tomaskovacik/ComfortTurnSignal/HW_kovo/pinout.jpg

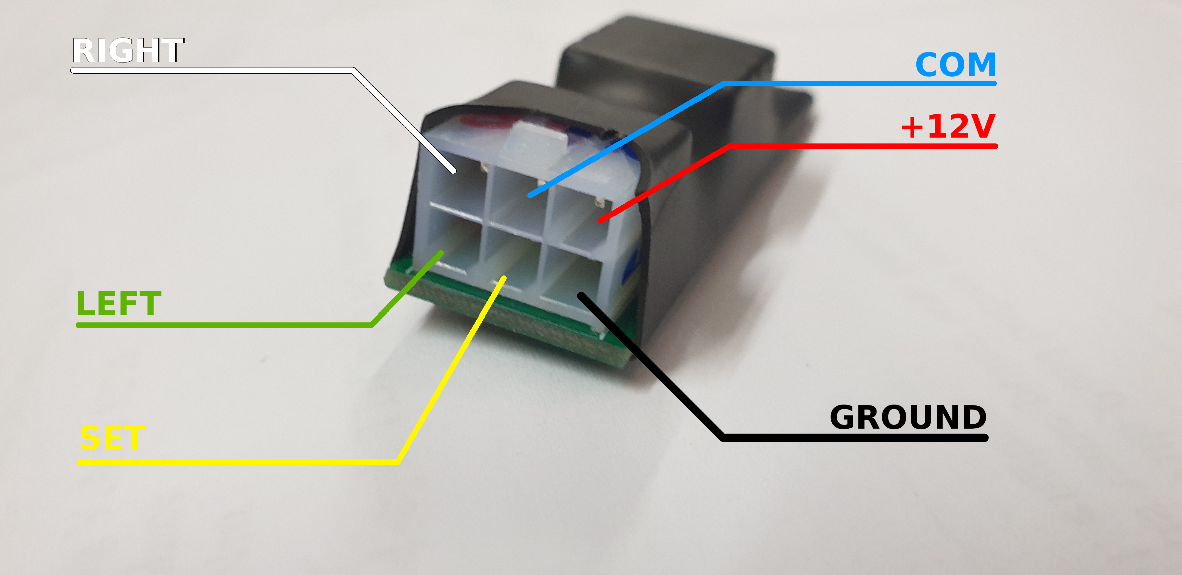
HW_kovo/pinout.jpg
