tomaskovacik/ComfortTurnSignal/HW_kovo/schematics_kovo.pdf

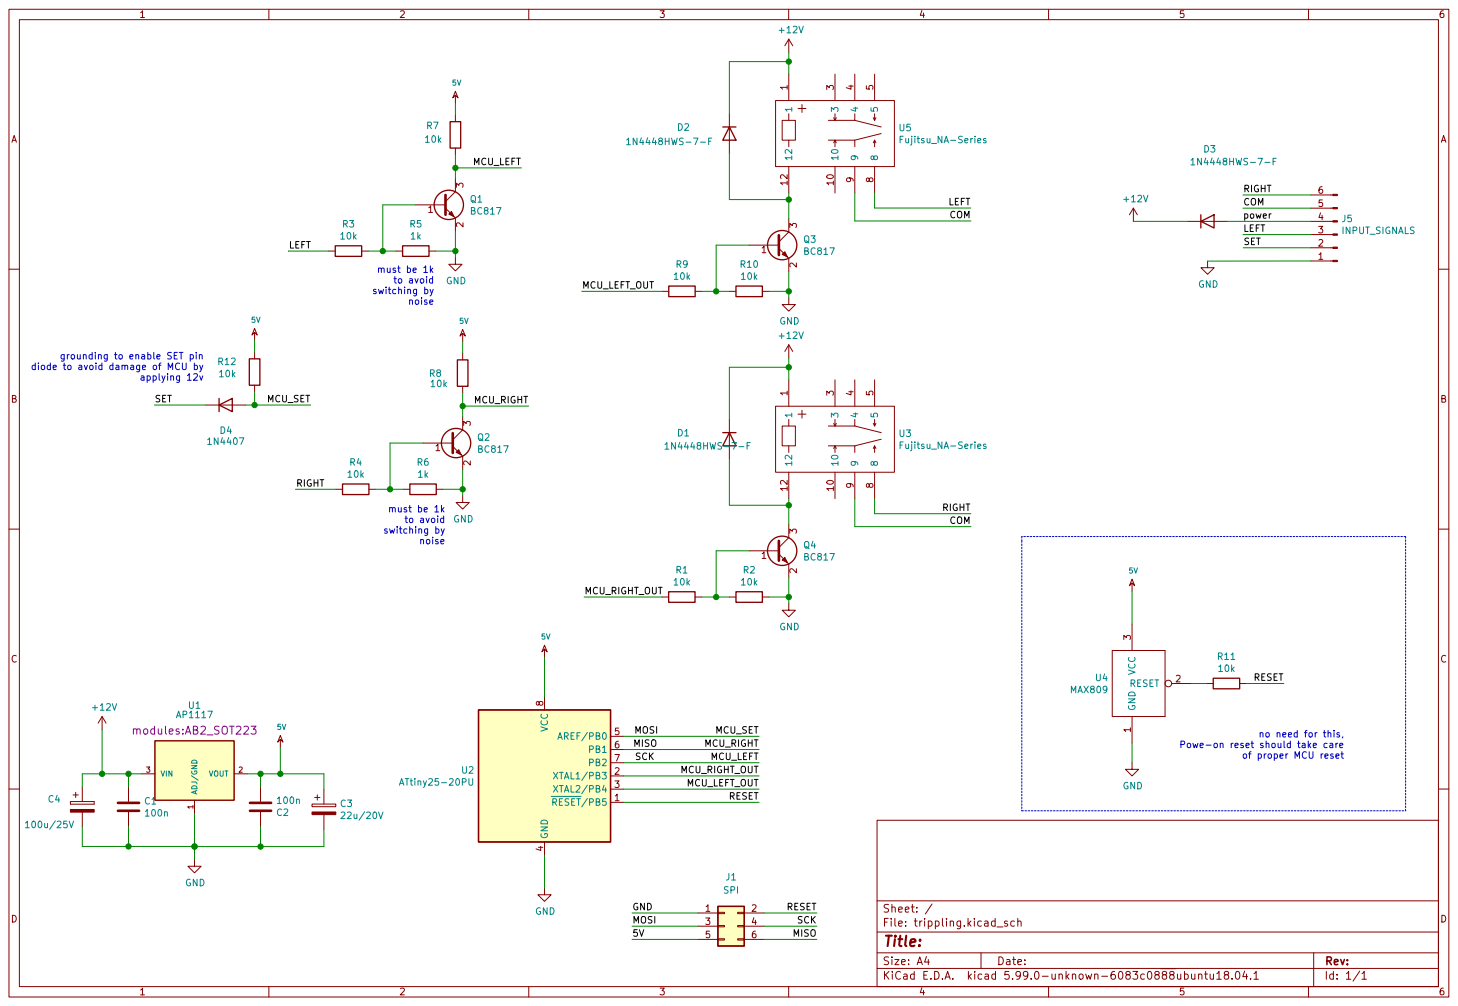
[picture p2: page 1]

switching by noise must be 1k

grounding to enable SET pin
diode to avoid damage of MCU by

of proper MCU reset
