tomaskovacik/ComfortTurnSignal/HW_kovo/trippling.kicad_pcb

## KiCad design HW_kovo/trippling.kicad_pcb (2021-08-12)

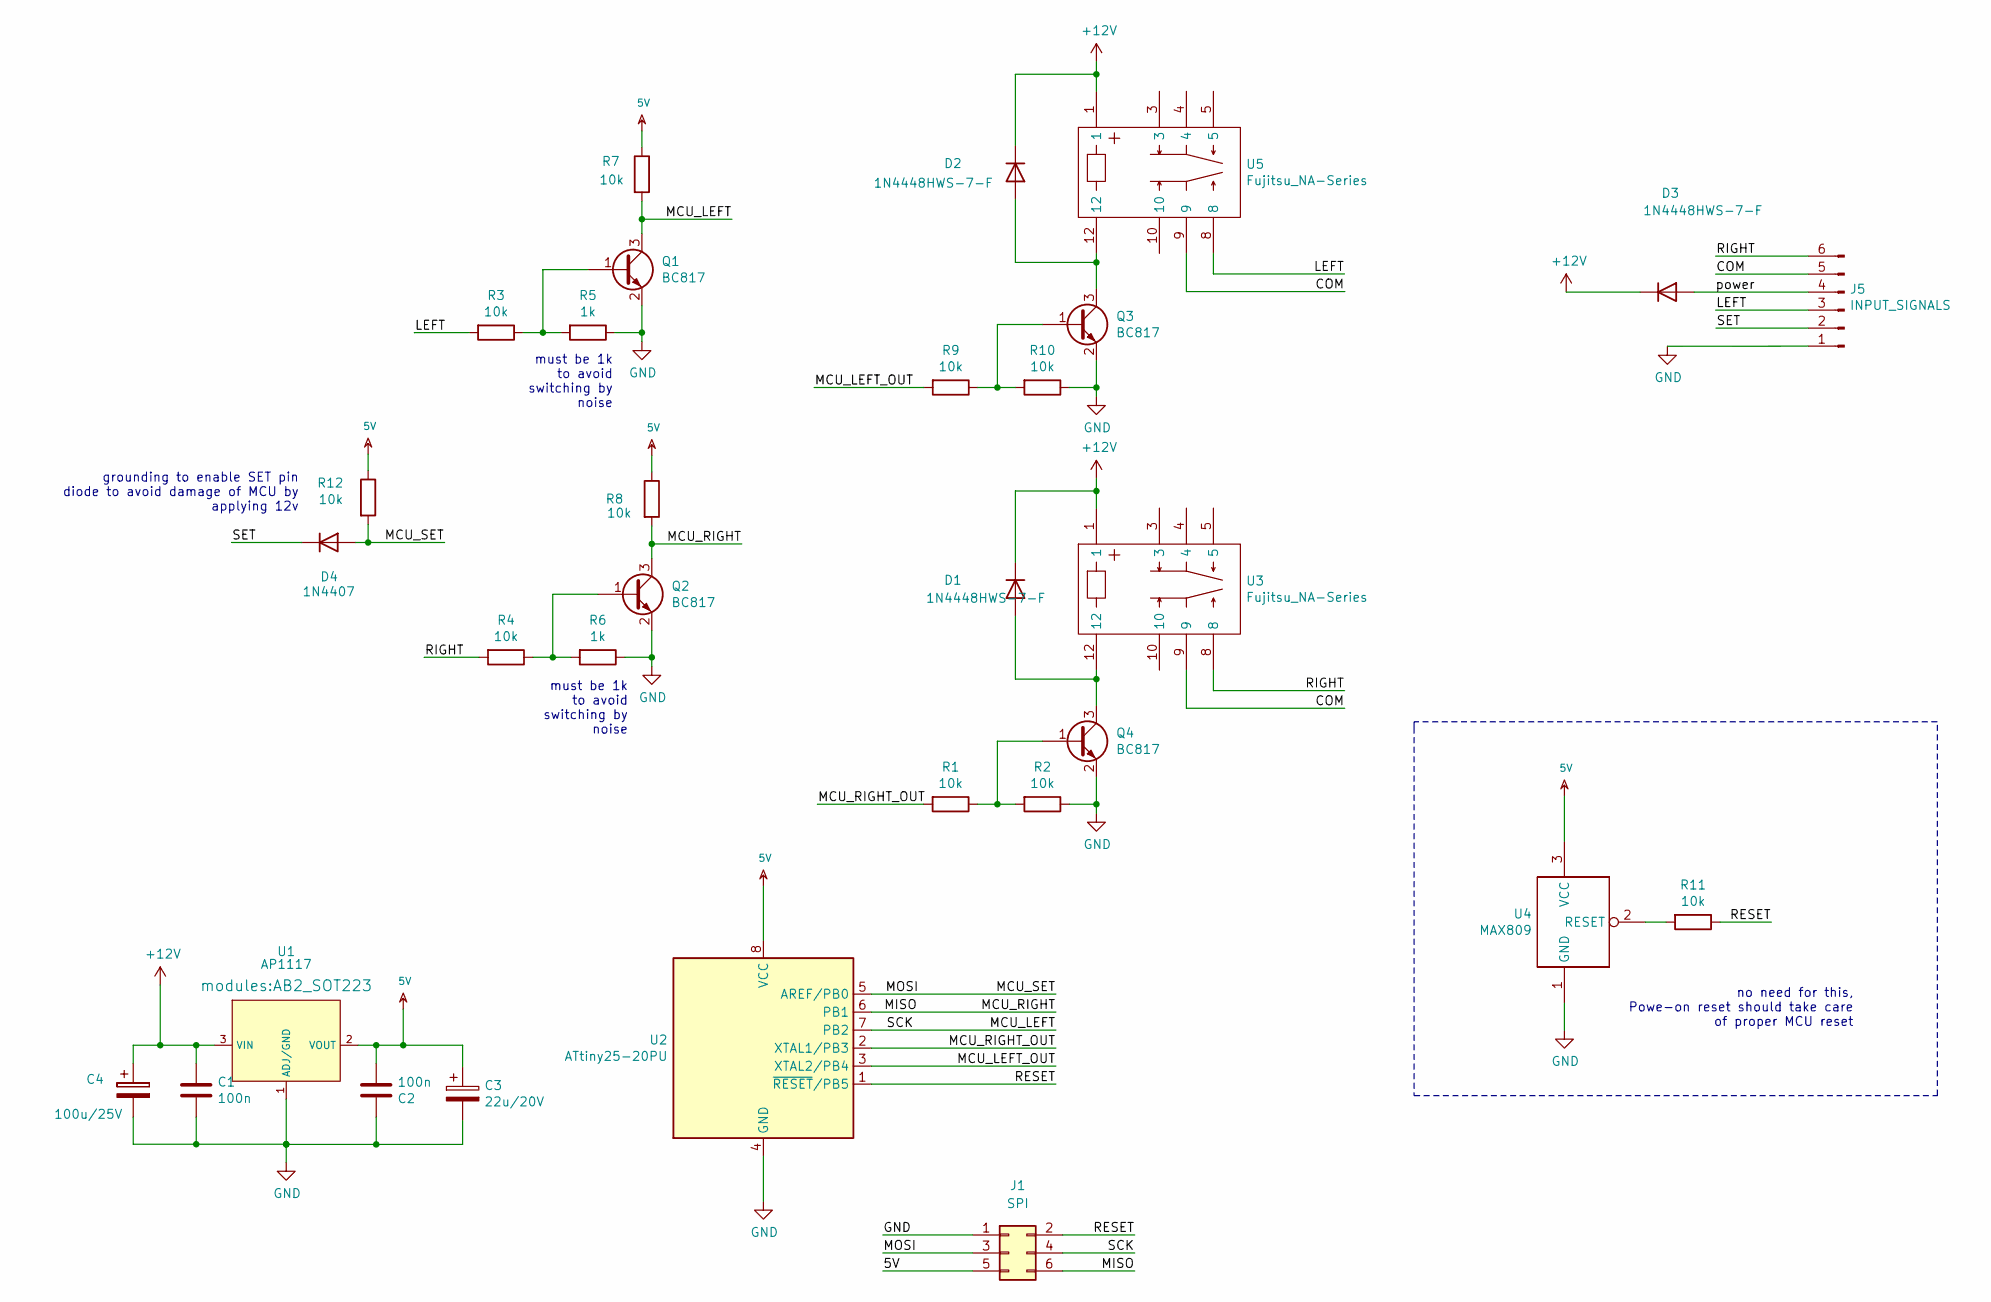
[picture p3: schematic trippling.kicad_sch]

Parts:
C1, C2: 100n; C_0805_HandSoldering
C3: 22u/20V; CP_Tantalum_Case-B_EIA-3528-21_Hand
C4: 100u/25V; CP_Tantalum_Case-D_EIA-7343-31_Hand
D1, D2, D3: 1N4448HWS-7-F; D_SOD-323_HandSoldering
D4: 1N4407; D_SOD-323_HandSoldering
J1: SPI; Pin_Header_Straight_2x03
J5: INPUT_SIGNALS; Molex_MiniFit-JR-5569-06A2_2x03x4.20mm_Angled
Q1, Q2, Q3, Q4: BC817; SOT-23_Handsoldering
R1, R2, R3, R4, R7, R8, R9, R10, R11, R12: 10k; R_0805_HandSoldering
R5, R6: 1k; R_0805_HandSoldering
U1: AP1117; AB2_SOT223
U2: ATtiny25-20PU; SO-8_5.3x6.2mm_Pitch1.27mm
U3, U5: Fujitsu_NA-Series; FUJITSU-NA-SERIES
U4: MAX809; SOT-23_Handsoldering

Connections:
5V: C2.2, C3.1, J1.5, R7.1, R8.1, R12.1, U1.2 (VOUT), U2.8 (VCC), U4.3 (VCC)
+12V: C1.1, C4.1, D1.1 (K), D2.1 (K), D3.1 (K), U1.3 (VIN), U3.1, U5.1
/COM: J5.5, U3.9, U5.9
/LEFT: J5.3, R3.2, U5.8
/MCU_LEFT: J1.4, Q1.3 (C), R7.2, U2.7 (PB2)
/MCU_LEFT_OUT: R9.2, U2.3 (XTAL2/PB4)
/MCU_RIGHT: J1.6, Q2.3 (C), R8.2, U2.6 (PB1)
/MCU_RIGHT_OUT: R1.2, U2.2 (XTAL1/PB3)
/MCU_SET: D4.2 (A), J1.3, R12.2, U2.5 (AREF/PB0)
/RESET: J1.2, R11.1, U2.1 (~RESET~/PB5)
/RIGHT: J5.6, R4.2, U3.8
/SET: D4.1 (K), J5.2
/power: D3.2 (A), J5.4
GND: C1.2, C2.1, C3.2, C4.2, J1.1, J5.1, Q1.2 (E), Q2.2 (E), Q3.2 (E), Q4.2 (E), R2.1, R5.1, R6.1, R10.1, U1.1 (ADJ/GND), U2.4 (GND), U4.1 (GND)
unnamed: D1.2 (A), Q4.3 (C), U3.12
unnamed: D2.2 (A), Q3.3 (C), U5.12
unnamed: Q1.1 (B), R3.1, R5.2
unnamed: Q2.1 (B), R4.1, R6.2
unnamed: Q3.1 (B), R9.1, R10.2
unnamed: Q4.1 (B), R1.1, R2.2
unnamed: R11.2, U4.2 (RESET)

Notes on the sheet:
grounding to enable SET pin diode to avoid damage of MCU by applying 12v
must be 1k to avoid switching by noise
no need for this, Powe-on reset should take care of proper MCU reset

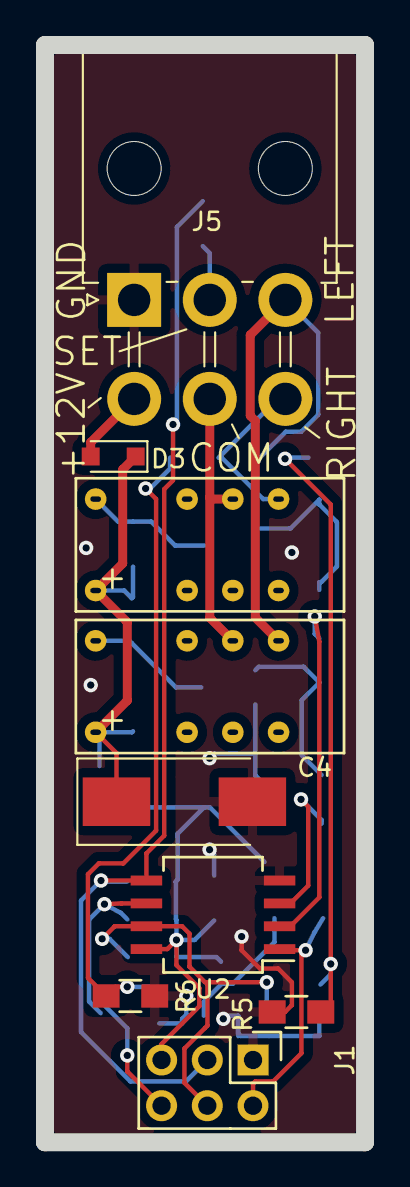
[picture p4: board trippling.kicad_pcb from above]

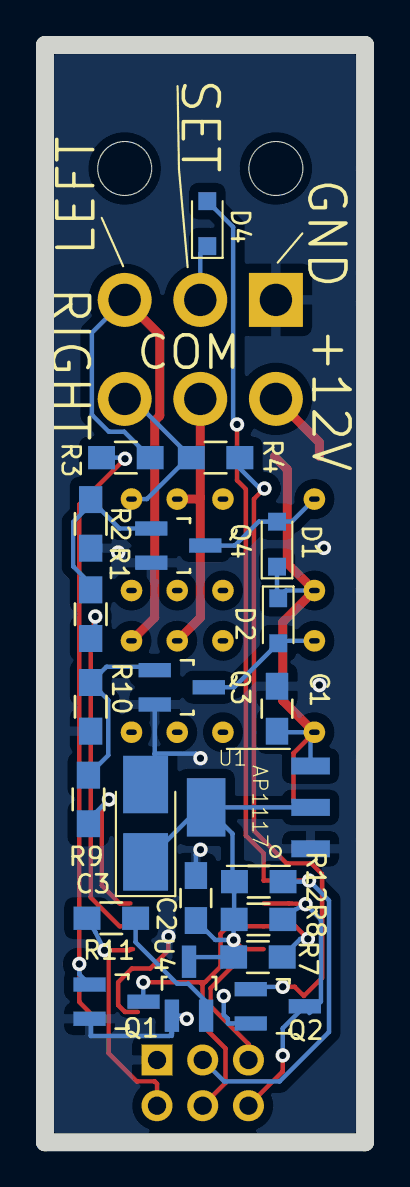
[picture p5: board trippling.kicad_pcb from below]

Board: 2 copper layers, 17.8 x 61.0 mm, 31 parts (22 on the bottom side), 21 nets.
