tomaskovacik/ComfortTurnSignal/HW_kovo/how_to_connect.png

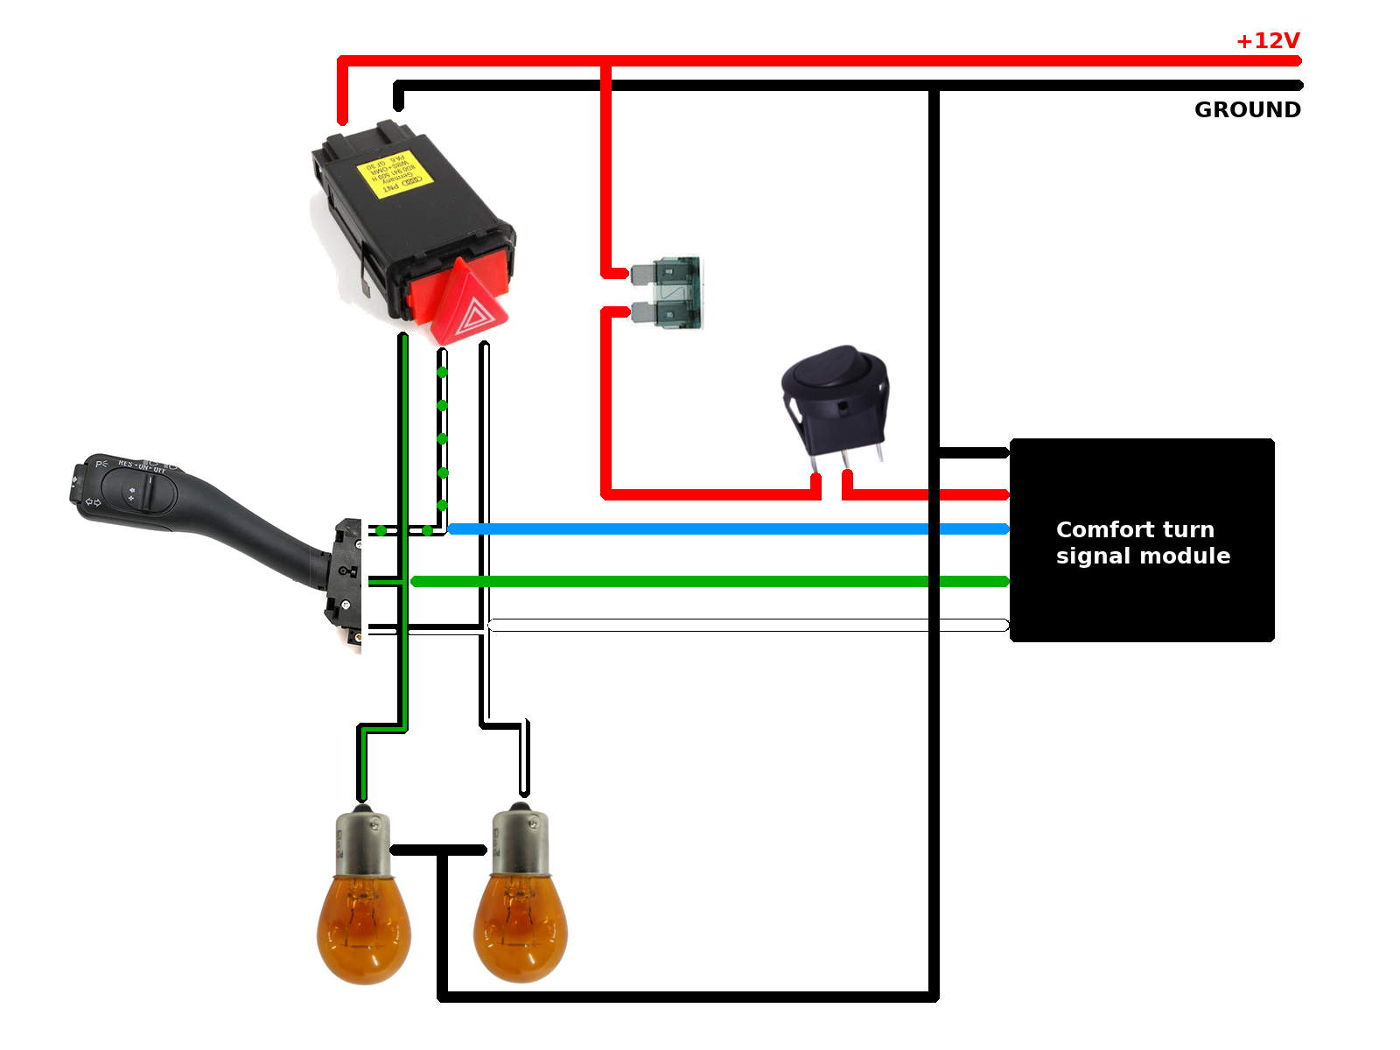
HW_kovo/how_to_connect.png
